Geometrically/baked-weights/gds_render.png

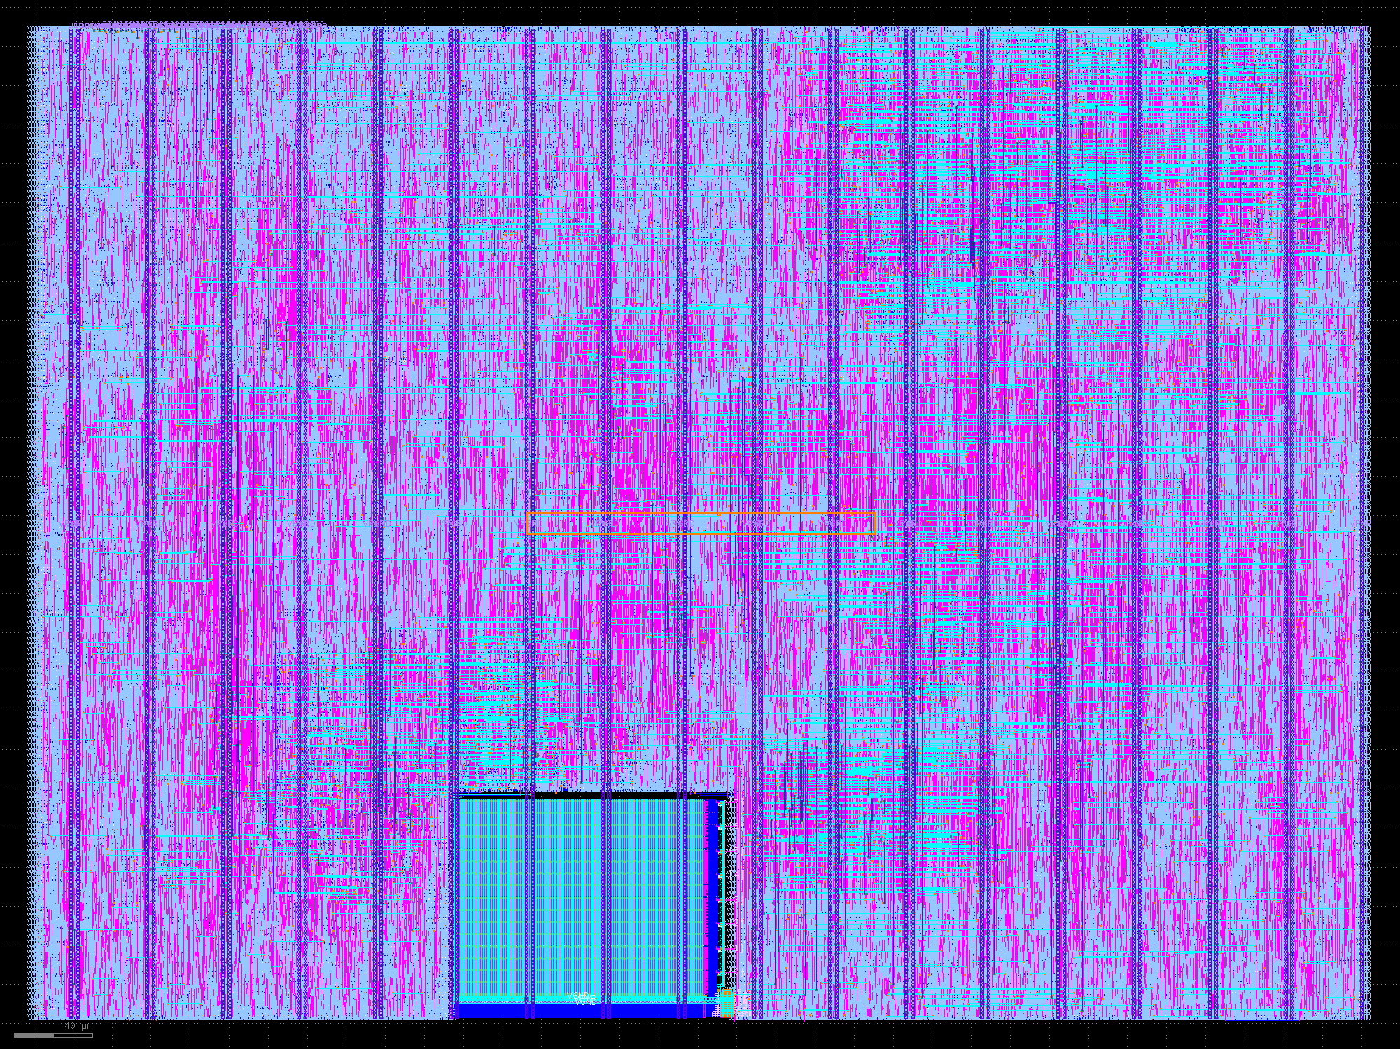
gds_render.png
