Geometrically/baked-weights/src/trit_dec5.v

// Base-3 packed byte -> 5 trits.  One trit is 2 bits: bit0 = non-zero, bit1 = sign.
// Digit d of the byte (base 3, least significant digit = lane 5k+0) means trit d-1, so
// 121 (all digits 1) is five zero trits and is the pad byte the generator emits.
module trit_dec5 (
  input  wire [7:0] b,
  output reg  [9:0] t
);
  always @(*) begin
    case (b)
      8'd0: t = 10'b1111111111;
      8'd1: t = 10'b1111111100;
      8'd2: t = 10'b1111111101;
      8'd3: t = 10'b1111110011;
      8'd4: t = 10'b1111110000;
      8'd5: t = 10'b1111110001;
      8'd6: t = 10'b1111110111;
      8'd7: t = 10'b1111110100;
      8'd8: t = 10'b1111110101;
      8'd9: t = 10'b1111001111;
      8'd10: t = 10'b1111001100;
      8'd11: t = 10'b1111001101;
      8'd12: t = 10'b1111000011;
      8'd13: t = 10'b1111000000;
      8'd14: t = 10'b1111000001;
      8'd15: t = 10'b1111000111;
      8'd16: t = 10'b1111000100;
      8'd17: t = 10'b1111000101;
      8'd18: t = 10'b1111011111;
      8'd19: t = 10'b1111011100;
      8'd20: t = 10'b1111011101;
      8'd21: t = 10'b1111010011;
      8'd22: t = 10'b1111010000;
      8'd23: t = 10'b1111010001;
      8'd24: t = 10'b1111010111;
      8'd25: t = 10'b1111010100;
      8'd26: t = 10'b1111010101;
      8'd27: t = 10'b1100111111;
      8'd28: t = 10'b1100111100;
      8'd29: t = 10'b1100111101;
      8'd30: t = 10'b1100110011;
      8'd31: t = 10'b1100110000;
      8'd32: t = 10'b1100110001;
      8'd33: t = 10'b1100110111;
      8'd34: t = 10'b1100110100;
      8'd35: t = 10'b1100110101;
      8'd36: t = 10'b1100001111;
      8'd37: t = 10'b1100001100;
      8'd38: t = 10'b1100001101;
      8'd39: t = 10'b1100000011;
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
      // 243..255 are not valid base-3 packings: X so a corrupt ROM byte propagates
      // instead of reading as zeros, and so synthesis may treat them as don't-care.
      default: t = 10'bx;
    endcase
  end
endmodule
